Pranav-adhith/Smart-Plant-Monitoring-Watering-System/Images/Oled reaction 2.jpeg

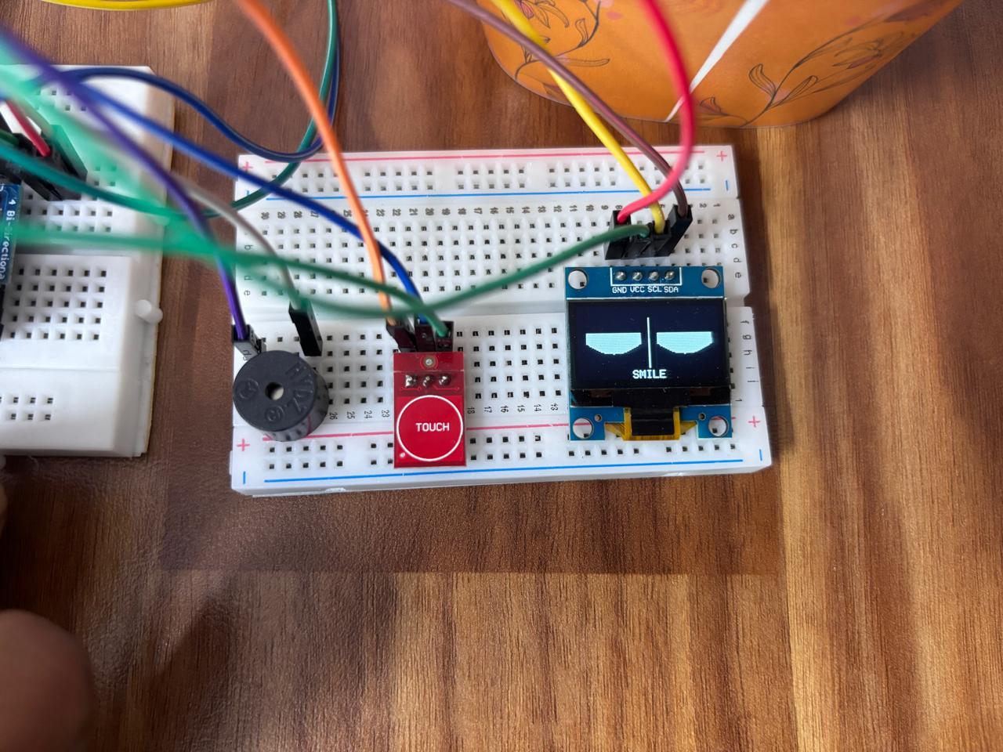
Images/Oled reaction 2.jpeg
