Pranav-adhith/Smart-Plant-Monitoring-Watering-System/Images/Complete circuit.jpeg

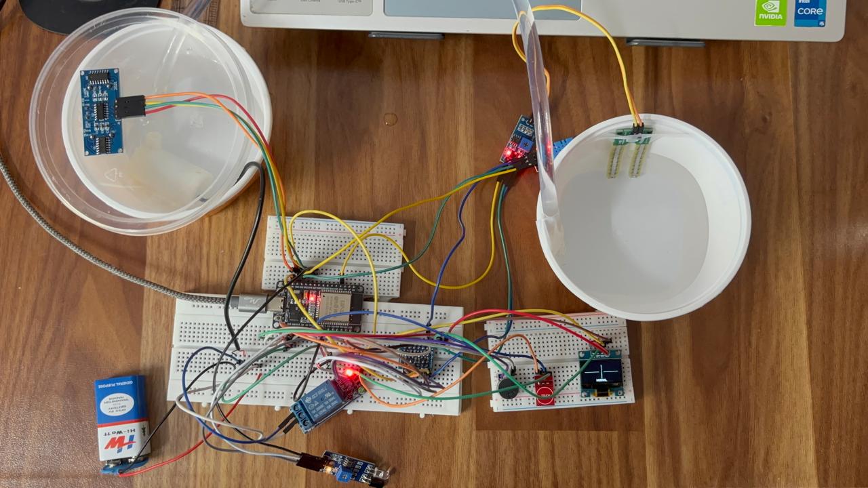
Images/Complete circuit.jpeg
