Pranav-adhith/Smart-Plant-Monitoring-Watering-System/CAD/CAD Model.png

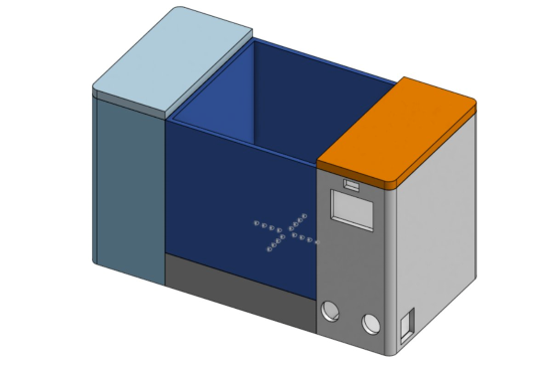
CAD/CAD Model.png
