Pranav-adhith/Smart-Plant-Monitoring-Watering-System/Images/Mobile App dashboard.jpeg

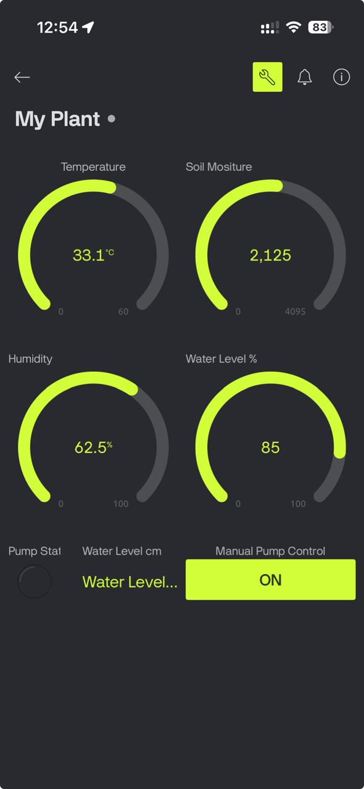
Images/Mobile App dashboard.jpeg
