Pranav-adhith/Smart-Plant-Monitoring-Watering-System/Images/Oled reaction 3.jpeg

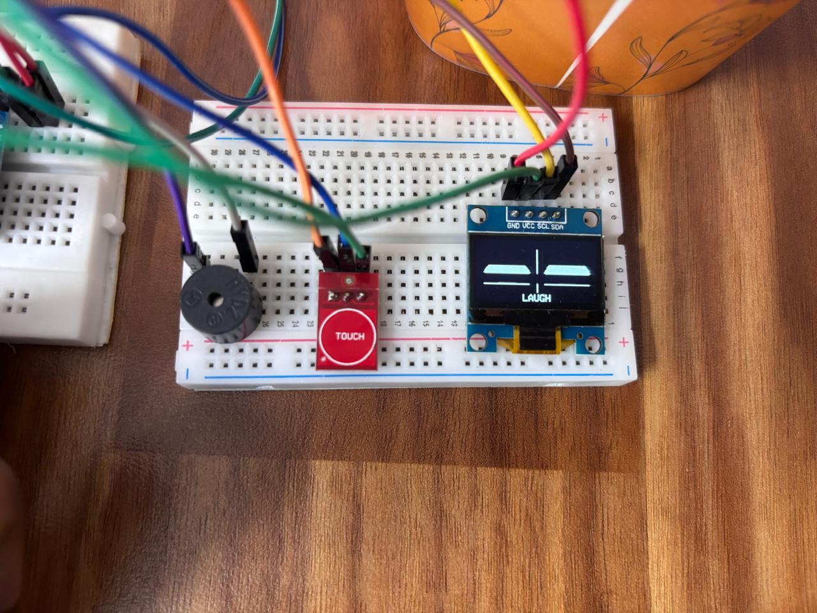
Images/Oled reaction 3.jpeg
