Pranav-adhith/Smart-Plant-Monitoring-Watering-System/Images/Oled reaction 4.jpeg

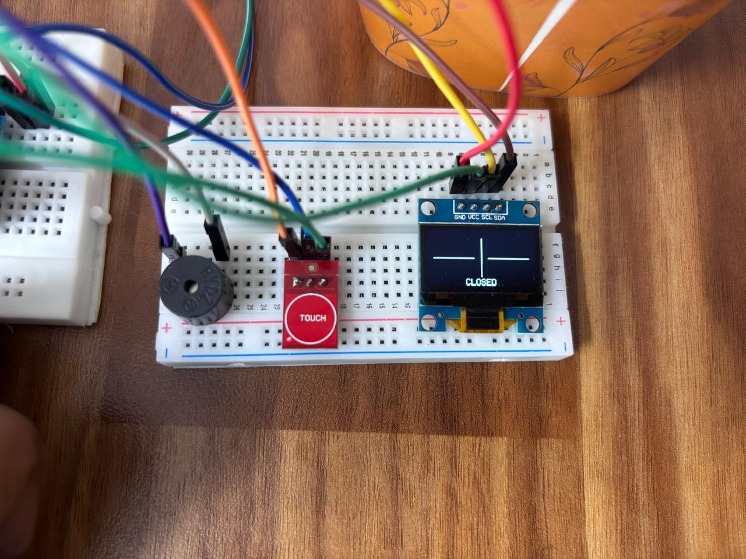
Images/Oled reaction 4.jpeg
