Pranav-adhith/Smart-Plant-Monitoring-Watering-System/Images/Soil.jpeg

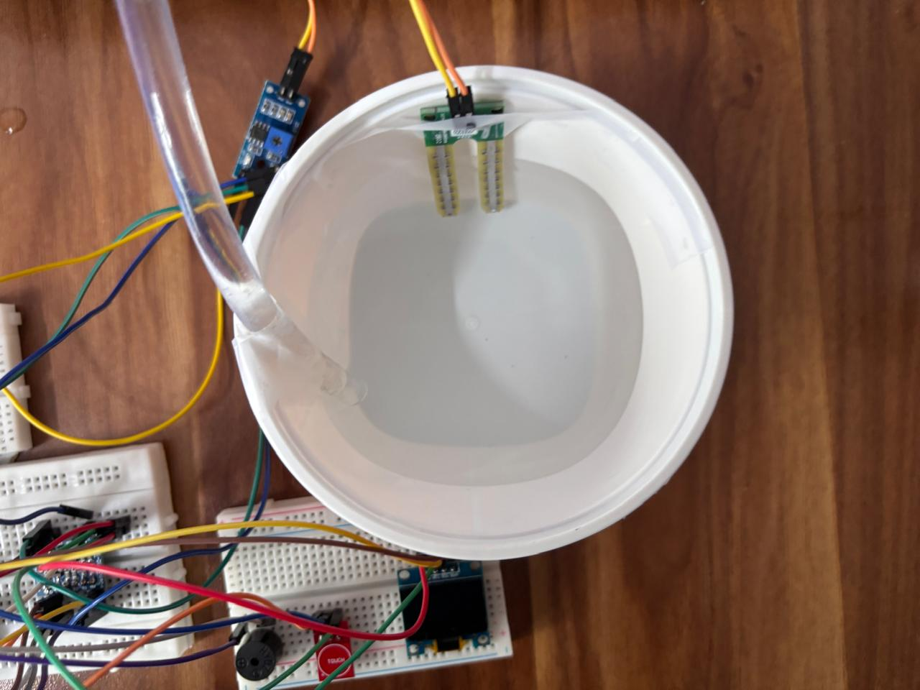
Images/Soil.jpeg
