Pranav-adhith/Smart-Plant-Monitoring-Watering-System/Images/Water Container.jpeg

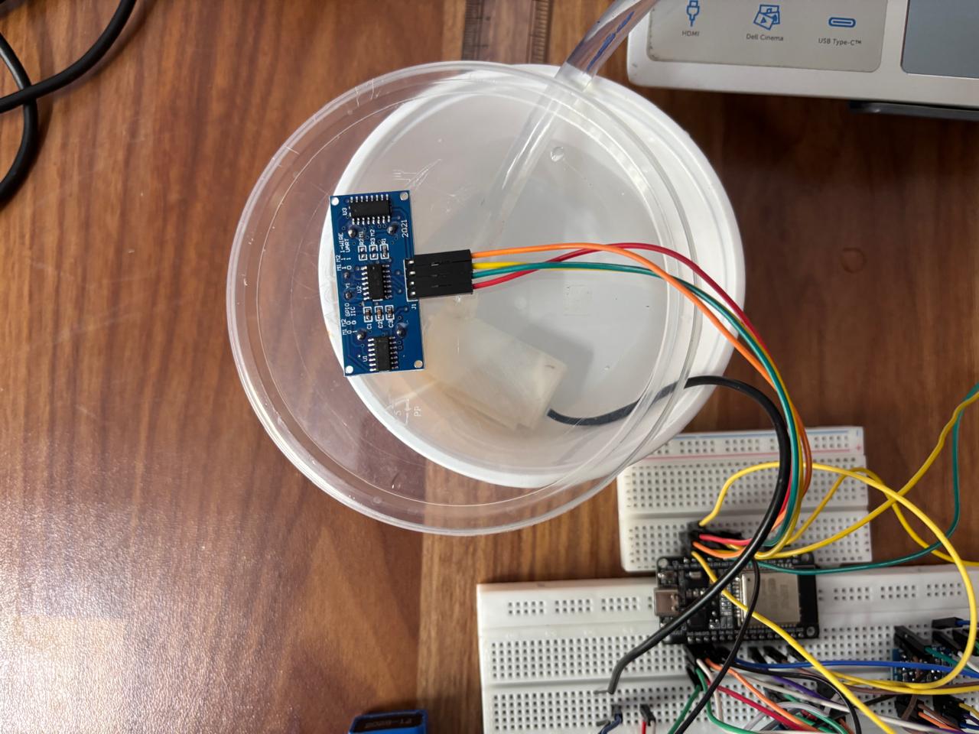
Images/Water Container.jpeg
