Pranav-adhith/Smart-Plant-Monitoring-Watering-System/Images/Web dashboard.png

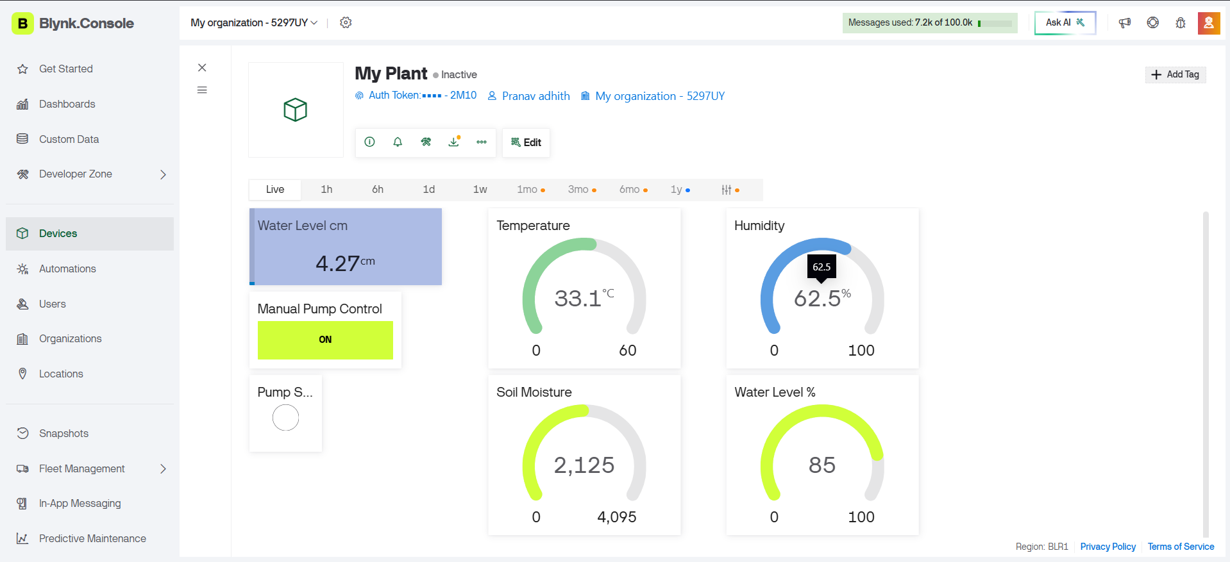
Images/Web dashboard.png
